BartenderButlerBot/Bartender/Eagle CAD/b3 bart - rev00.brd

## EAGLE design Eagle CAD/b3 bart - rev00.brd (2020-03-20)

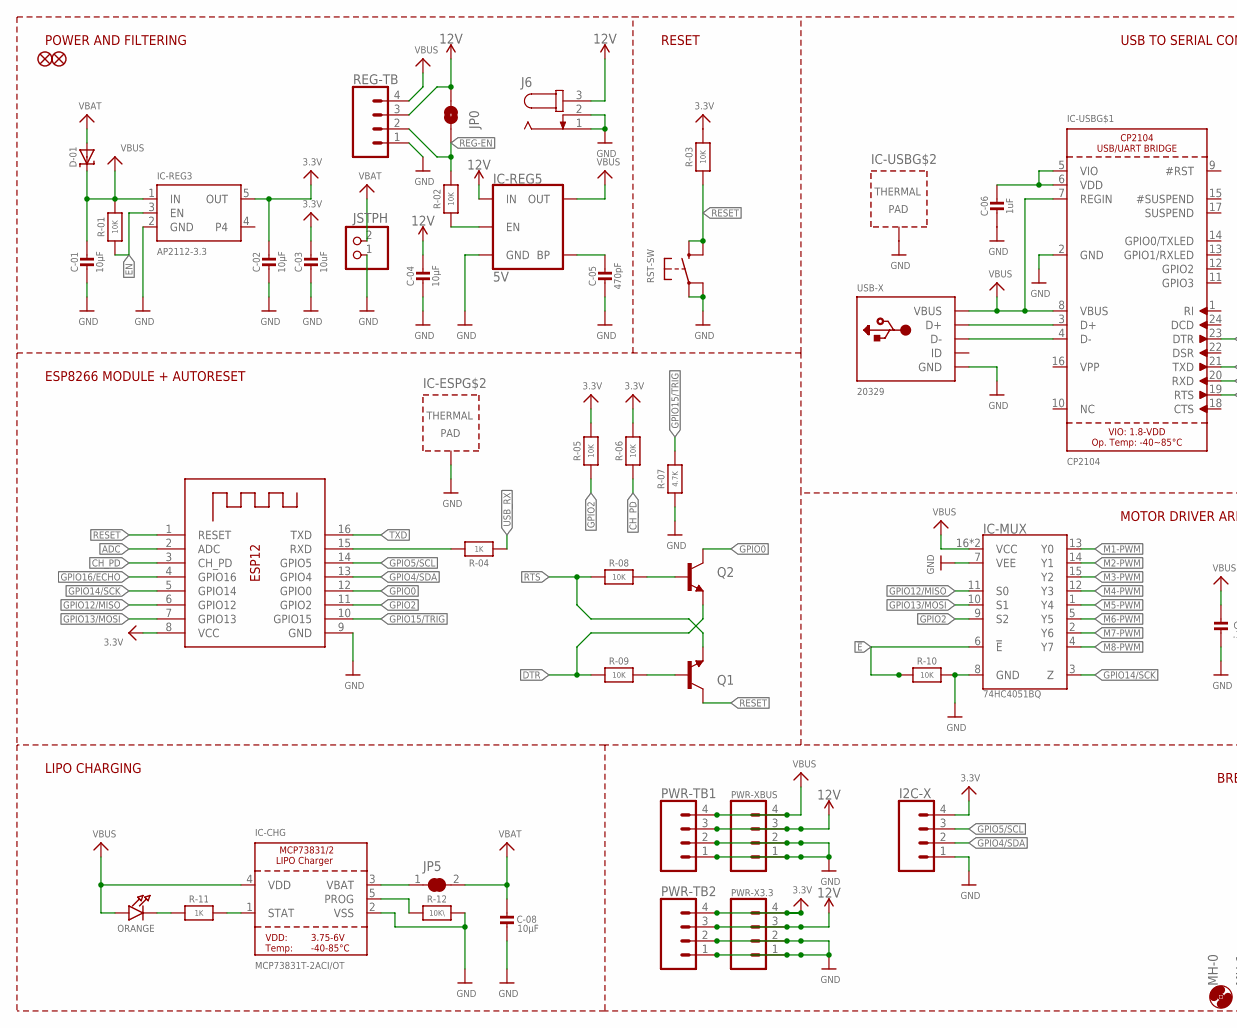
[picture p1: schematic b3 bart - rev00.sch, part in row 1, column 1]

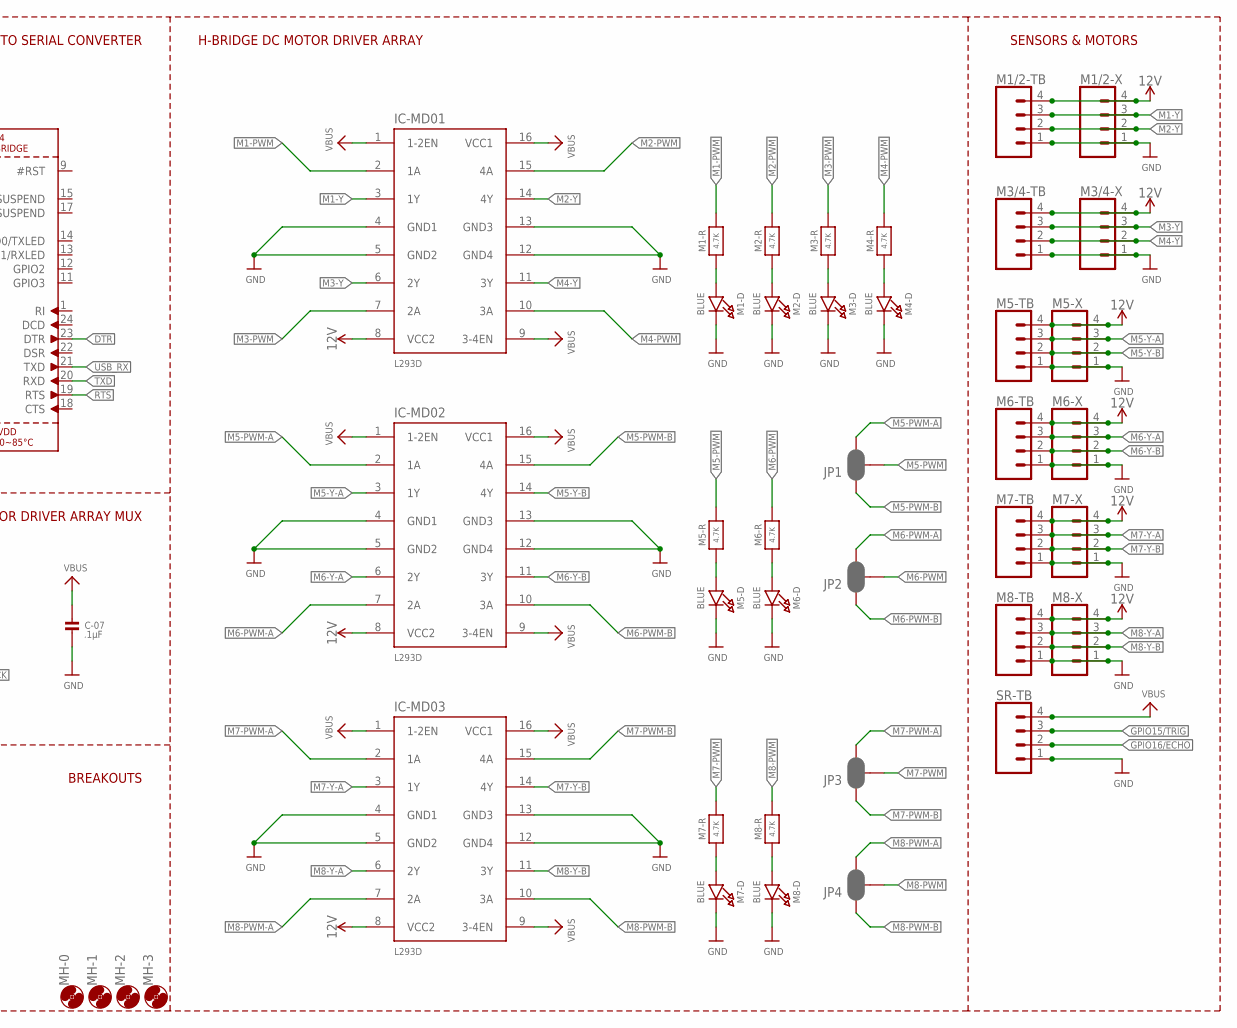
[picture p2: schematic b3 bart - rev00.sch, part in row 1, column 2]

Parts:
C-01, C-02, C-04, C-08: 10µF; 0805-NO
C-03: 10uF; 0805-NO
C-05: 470pF; 0805-NO
C-06: 1uF; 0603-NO@1
C-07: .1µF; 0805-NO
CHG-D: ORANGE; CHIPLED_0805_NOOUTLINE
D-01: MBR120; SOD-123
FD1, FD2: FIDUCIAL1X2; FIDUCIAL-1X2
I2C-X: CONN_04LONGPADS; 1X04_LONGPADS
IC-CHG: MCP73831T-2ACI/OT; SOT23-5
IC-ESP: ESP-12; ESP-12S
IC-MD01, IC-MD02, IC-MD03: L293D; DIL16
IC-MUX: 74HC4051BQ; DHVQFN-16-2.5X3.5MM
IC-REG3: AP2112-3.3; SOT23-5
IC-REG5: 5V; SOT23-5
IC-USB: CP2104; QFN24_4MM_SMSC
J6: JACK-PLUG1; SPC4078
JP0: JUMPER-SMT_2_NO_SILK; SMT-JUMPER_2_NO_SILK
JP1, JP2, JP3, JP4: JUMPER-SMT_3_2-NC_PASTE_SILK; SMT-JUMPER_3_2-NC_PASTE_SILK
JP5: SOLDERJUMPER_CLOSED; SOLDERJUMPER_CLOSEDWIRE
M1-D, M2-D, M3-D, M4-D, M5-D, M6-D, M7-D, M8-D: BLUE; CHIPLED_0805_NOOUTLINE
M1-R, M2-R, M3-R, M4-R, M5-R, M6-R, M7-R, M8-R: 4.7K; 0603-NO
M1/2-TB, M3/4-TB, M5-TB, M6-TB, M7-TB, M8-TB: CONN_04SCREW; SCREWTERMINAL-3.5MM-4
M1/2-X, M3/4-X, M5-X, M6-X, M7-X, M8-X: CONN_04LONGPADS; 1X04_LONGPADS
MH-0, MH-1, MH-2, MH-3: MOUNT-HOLE3.0; 3,0
PWR-TB1, PWR-TB2: CONN_04SCREW; SCREWTERMINAL-3.5MM-4
PWR-X3.3: CONN_04LONGPADS; 1X04_LONGPADS
PWR-XBUS: CONN_04LONGPADS; 1X04_LONGPADS
Q1, Q2: mmbt2222; SOT23-3
R-01, R-02, R-03, R-05, R-06, R-08, R-09, R-10: 10K; 0603-NO
R-04: 1K; _0603MP
R-07: 4.7K; 0603-NO
R-11: 1K; 0603-NO
R-12: 10K\; 0603-NO
REG-TB: CONN_04SCREW; SCREWTERMINAL-3.5MM-4
RST-SW: KMR2; BTN_KMR2_4.6X2.8
SR-TB: CONN_04SCREW; SCREWTERMINAL-3.5MM-4
USB-X: 20329; 4UCONN_20329_V2
X1: JSTPH; JSTPH2

Connections:
3.3V: C-02.1, C-03.1, I2C-X.4, IC-ESP.8 (VCC), IC-REG3.5 (OUT), PWR-TB2.4, PWR-X3.3.4, R-03.2, R-05.2, R-06.2
12V: C-04.1, IC-MD01.8 (VCC2), IC-MD02.8 (VCC2), IC-MD03.8 (VCC2), IC-REG5.1 (IN), J6.3, JP0.2, M1/2-TB.4, M1/2-X.4, M3/4-TB.4, M3/4-X.4, M5-TB.4, M5-X.4, M6-TB.4, M6-X.4, M7-TB.4, M7-X.4, M8-TB.4, M8-X.4, PWR-TB1.3, PWR-TB2.3, PWR-X3.3.3, PWR-XBUS.3, REG-TB.3
!E!: IC-MUX.6 (!E!), R-10.1
ADC: IC-ESP.2 (ADC)
CH_PD: IC-ESP.3 (CH_PD), R-06.1
D+: IC-USB.3 (D+), USB-X.D+
D-: IC-USB.4 (D-), USB-X.D-
DTR: IC-USB.23 (DTR), Q2.2 (E), R-09.1
EN: IC-REG3.3 (EN), R-01.1
GND: C-01.2, C-02.2, C-03.2, C-04.2, C-05.2, C-06.2, C-07.2, C-08.2, I2C-X.1, IC-CHG.2 (VSS), IC-ESP.9 (GND), IC-ESP.P$1 (TP), IC-MD01.4 (GND1), IC-MD01.5 (GND2), IC-MD01.12 (GND4), IC-MD01.13 (GND3), IC-MD02.4 (GND1), IC-MD02.5 (GND2), IC-MD02.12 (GND4), IC-MD02.13 (GND3), IC-MD03.4 (GND1), IC-MD03.5 (GND2), IC-MD03.12 (GND4), IC-MD03.13 (GND3), IC-MUX.7 (VEE), IC-MUX.8 (GND), IC-REG3.2 (GND), IC-REG5.2 (GND), IC-USB.2 (GND), IC-USB.THERM (TP), J6.1, J6.2, M1-D.C, M1/2-TB.1, M1/2-X.1, M2-D.C, M3-D.C, M3/4-TB.1, M3/4-X.1, M4-D.C, M5-D.C, M5-TB.1, M5-X.1, M6-D.C, M6-TB.1, M6-X.1, M7-D.C, M7-TB.1, M7-X.1, M8-D.C, M8-TB.1, M8-X.1, PWR-TB1.1, PWR-TB1.2, PWR-TB2.1, PWR-TB2.2, PWR-X3.3.1, PWR-X3.3.2, PWR-XBUS.1, PWR-XBUS.2, R-07.1, R-10.2, R-12.2, REG-TB.1, RST-SW.A, RST-SW.A' (P1), SR-TB.1, USB-X.BASE@1 (GND), USB-X.BASE@2 (GND), USB-X.GND, USB-X.SPRT@1 (GND), USB-X.SPRT@2 (GND), USB-X.SPRT@3 (GND), USB-X.SPRT@4 (GND), X1.1
GPIO0: IC-ESP.12 (GPIO0), Q2.3 (C)
GPIO2: IC-ESP.11 (GPIO2), IC-MUX.9 (S2), R-05.1
GPIO4/SDA: I2C-X.2, IC-ESP.13 (GPIO4)
GPIO5/SCL: I2C-X.3, IC-ESP.14 (GPIO5)
GPIO12/MISO: IC-ESP.6 (GPIO12), IC-MUX.11 (S0)
GPIO13/MOSI: IC-ESP.7 (GPIO13), IC-MUX.10 (S1)
GPIO14/SCK: IC-ESP.5 (GPIO14), IC-MUX.3 (Z)
GPIO15/TRIG: IC-ESP.10 (GPIO15), R-07.2, SR-TB.3
GPIO16/ECHO: IC-ESP.4 (GPIO16), SR-TB.2
M1-PWM: IC-MD01.2 (1A), IC-MUX.13 (Y0), M1-R.2
M1-Y: IC-MD01.3 (1Y), M1/2-TB.3, M1/2-X.3
M2-PWM: IC-MD01.15 (4A), IC-MUX.14 (Y1), M2-R.2
M2-Y: IC-MD01.14 (4Y), M1/2-TB.2, M1/2-X.2
M3-PWM: IC-MD01.7 (2A), IC-MUX.15 (Y2), M3-R.2
M3-Y: IC-MD01.6 (2Y), M3/4-TB.3, M3/4-X.3
M4-PWM: IC-MD01.10 (3A), IC-MUX.12 (Y3), M4-R.2
M4-Y: IC-MD01.11 (3Y), M3/4-TB.2, M3/4-X.2
M5-PWM: IC-MUX.1 (Y4), JP1.2, M5-R.2
M5-PWM-A: IC-MD02.2 (1A), JP1.3
M5-PWM-B: IC-MD02.15 (4A), JP1.1
M5-Y-A: IC-MD02.3 (1Y), M5-TB.3, M5-X.3
M5-Y-B: IC-MD02.14 (4Y), M5-TB.2, M5-X.2
M6-PWM: IC-MUX.5 (Y5), JP2.2, M6-R.2
M6-PWM-A: IC-MD02.7 (2A), JP2.3
M6-PWM-B: IC-MD02.10 (3A), JP2.1
M6-Y-A: IC-MD02.6 (2Y), M6-TB.3, M6-X.3
M6-Y-B: IC-MD02.11 (3Y), M6-TB.2, M6-X.2
M7-PWM: IC-MUX.2 (Y6), JP3.2, M7-R.2
M7-PWM-A: IC-MD03.2 (1A), JP3.3
M7-PWM-B: IC-MD03.15 (4A), JP3.1
M7-Y-A: IC-MD03.3 (1Y), M7-TB.3, M7-X.3
M7-Y-B: IC-MD03.14 (4Y), M7-TB.2, M7-X.2
M8-PWM: IC-MUX.4 (Y7), JP4.2, M8-R.2
M8-PWM-A: IC-MD03.7 (2A), JP4.3
M8-PWM-B: IC-MD03.10 (3A), JP4.1
M8-Y-A: IC-MD03.6 (2Y), M8-TB.3, M8-X.3
M8-Y-B: IC-MD03.11 (3Y), M8-TB.2, M8-X.2
unnamed: CHG-D.C, R-11.1
unnamed: M5-D.A, M5-R.1
unnamed: IC-CHG.1 (STAT), R-11.2
unnamed: IC-CHG.5 (PROG), R-12.1
unnamed: M6-D.A, M6-R.1
unnamed: M1-D.A, M1-R.1
unnamed: IC-CHG.3 (VBAT), JP5.1
unnamed: C-06.1, IC-USB.5 (VIO), IC-USB.6 (VDD)
unnamed: M2-D.A, M2-R.1
unnamed: IC-REG5.3 (EN), R-02.1
unnamed: M7-D.A, M7-R.1
unnamed: Q1.1 (B), R-09.2
unnamed: Q2.1 (B), R-08.2
unnamed: M8-D.A, M8-R.1
unnamed: M3-D.A, M3-R.1
unnamed: M4-D.A, M4-R.1
unnamed: C-05.1, IC-REG5.4 (BP)
REG-EN: JP0.1, R-02.2, REG-TB.2
RESET: IC-ESP.1 (RESET), Q1.3 (C), R-03.1, RST-SW.B (S), RST-SW.B' (S1)
RTS: IC-USB.19 (RTS), Q1.2 (E), R-08.1
RXD: IC-ESP.15 (RXD), R-04.2
TXD: IC-ESP.16 (TXD), IC-USB.20 (RXD)
USB_RX: IC-USB.21 (TXD), R-04.1
VBAT: C-08.1, D-01.A, JP5.2, X1.2
VBUS: C-01.1, C-07.1, CHG-D.A, D-01.C, IC-CHG.4 (VDD), IC-MD01.1 (1-2EN), IC-MD01.9 (3-4EN), IC-MD01.16 (VCC1), IC-MD02.1 (1-2EN), IC-MD02.9 (3-4EN), IC-MD02.16 (VCC1), IC-MD03.1 (1-2EN), IC-MD03.9 (3-4EN), IC-MD03.16 (VCC1), IC-MUX.16 (VCC), IC-MUX.EP (VCC), IC-REG3.1 (IN), IC-REG5.5 (OUT), IC-USB.7 (REGIN), IC-USB.8 (VBUS), PWR-TB1.4, PWR-XBUS.4, R-01.2, REG-TB.4, SR-TB.4, USB-X.VBUS

Notes on the sheet:
POWER AND FILTERING
RESET
LIPO CHARGING
ESP8266 MODULE + AUTORESET
H-BRIDGE DC MOTOR DRIVER ARRAY
USB TO SERIAL CONVERTER
MOTOR DRIVER ARRAY MUX
BREAKOUTS
SENSORS & MOTORS

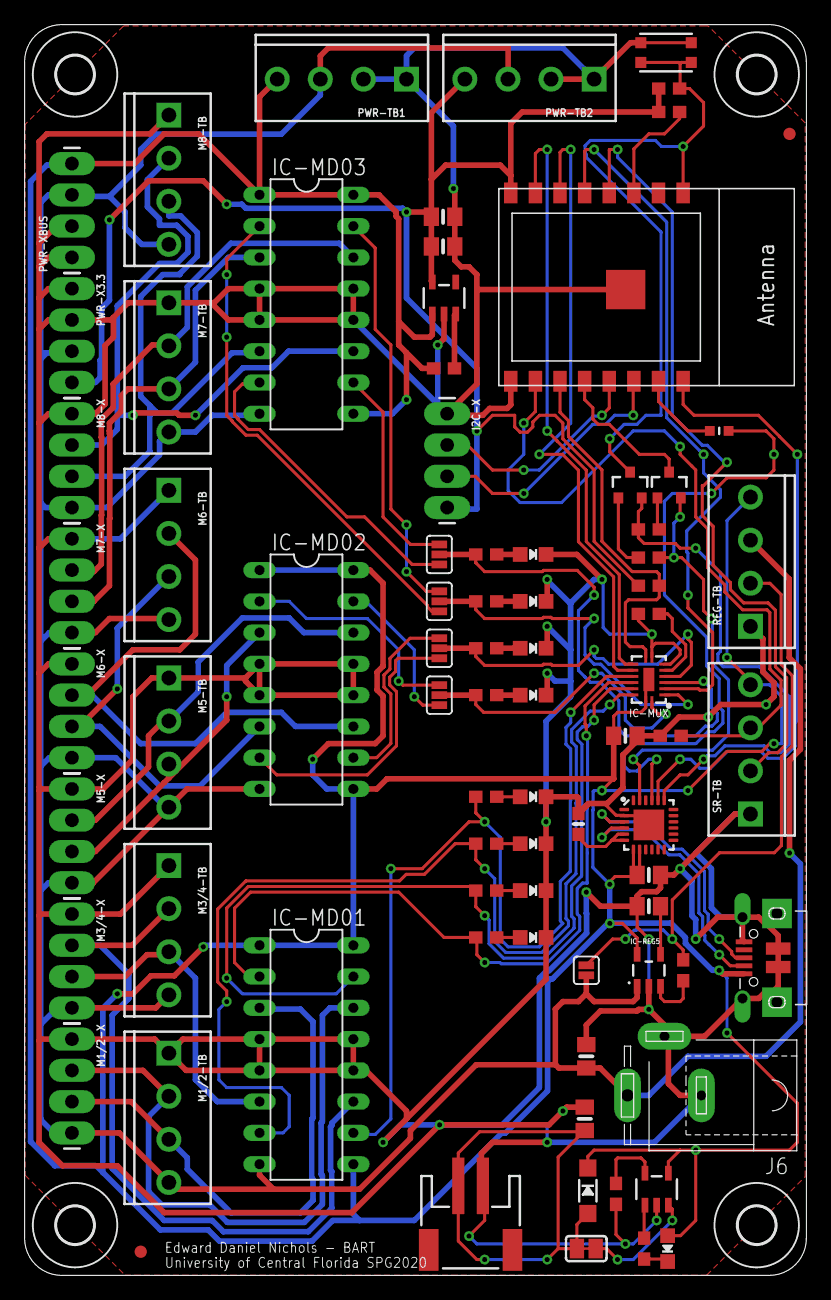
[picture p3: board b3 bart - rev00.brd from above]

Board: 2 copper layers, 63.5 x 101.6 mm, 84 parts (0 on the bottom side), 71 nets.
