BartenderButlerBot/Bartender/(commit log)

2020-03-12 CAD, firmware blitz
2020-03-20 Eagle PCB files, as submitted for quotation
    [b3 bart - rev00.brd, b3 bart - rev00.sch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]
2020-04-10 switched libraries to pubsub and it works
2020-04-10 parsing incoming messages, almost auto pumps
